Tyrion1606/robo_equilibrista_arduino_nano/docs/pinagem-dois-motores.png

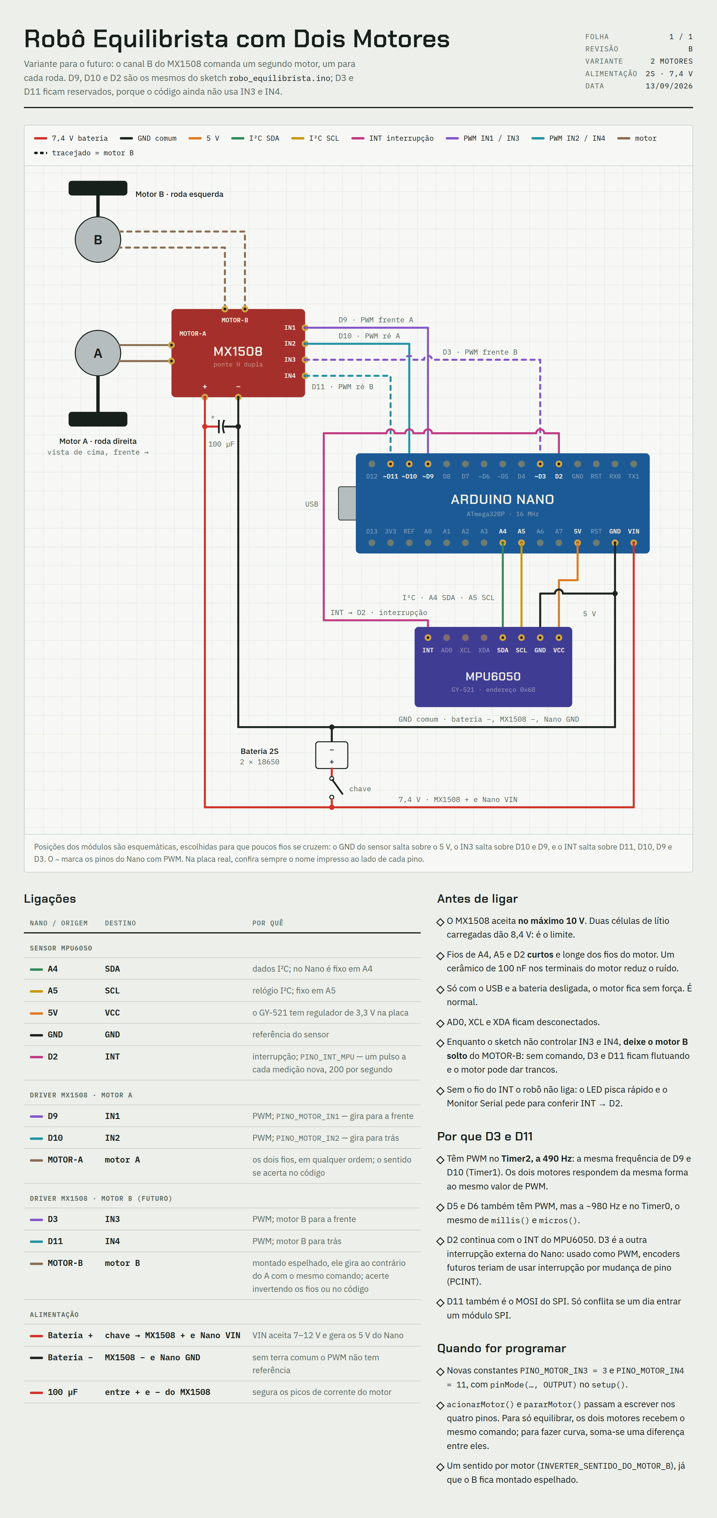
docs/pinagem-dois-motores.png
