Tyrion1606/robo_equilibrista_arduino_nano/docs/pinagem.png

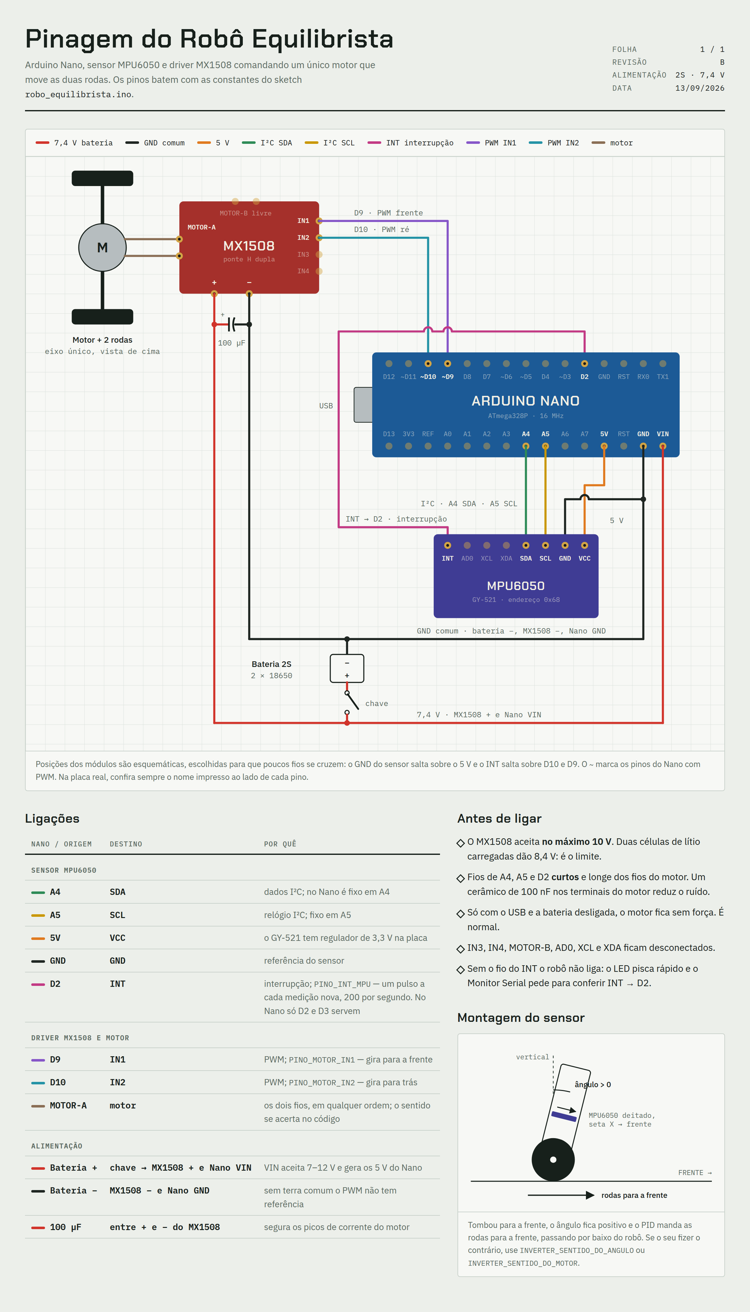
docs/pinagem.png
