Tyrion1606/robo_equilibrista_arduino_nano/estrutura_CAD/images/Base_v40.png

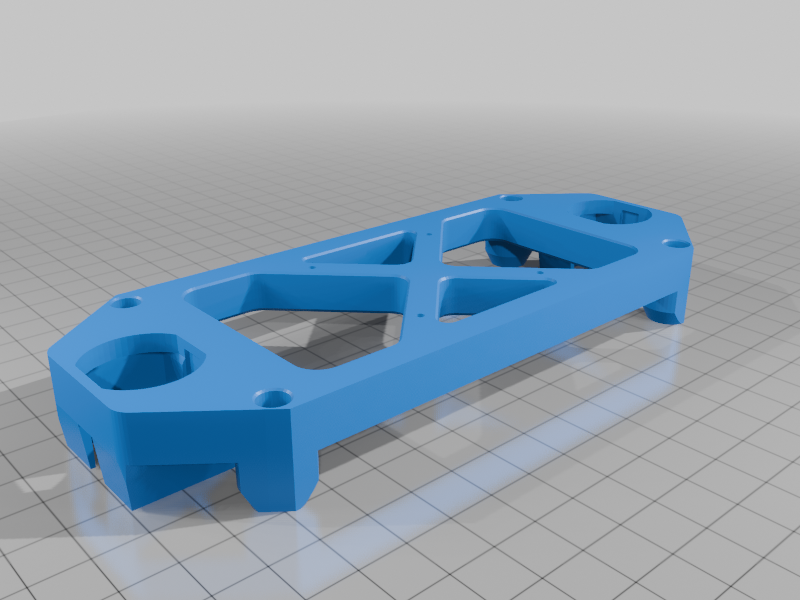
estrutura_CAD/images/Base_v40.png
