Tyrion1606/robo_equilibrista_arduino_nano/estrutura_CAD/images/BOT.png

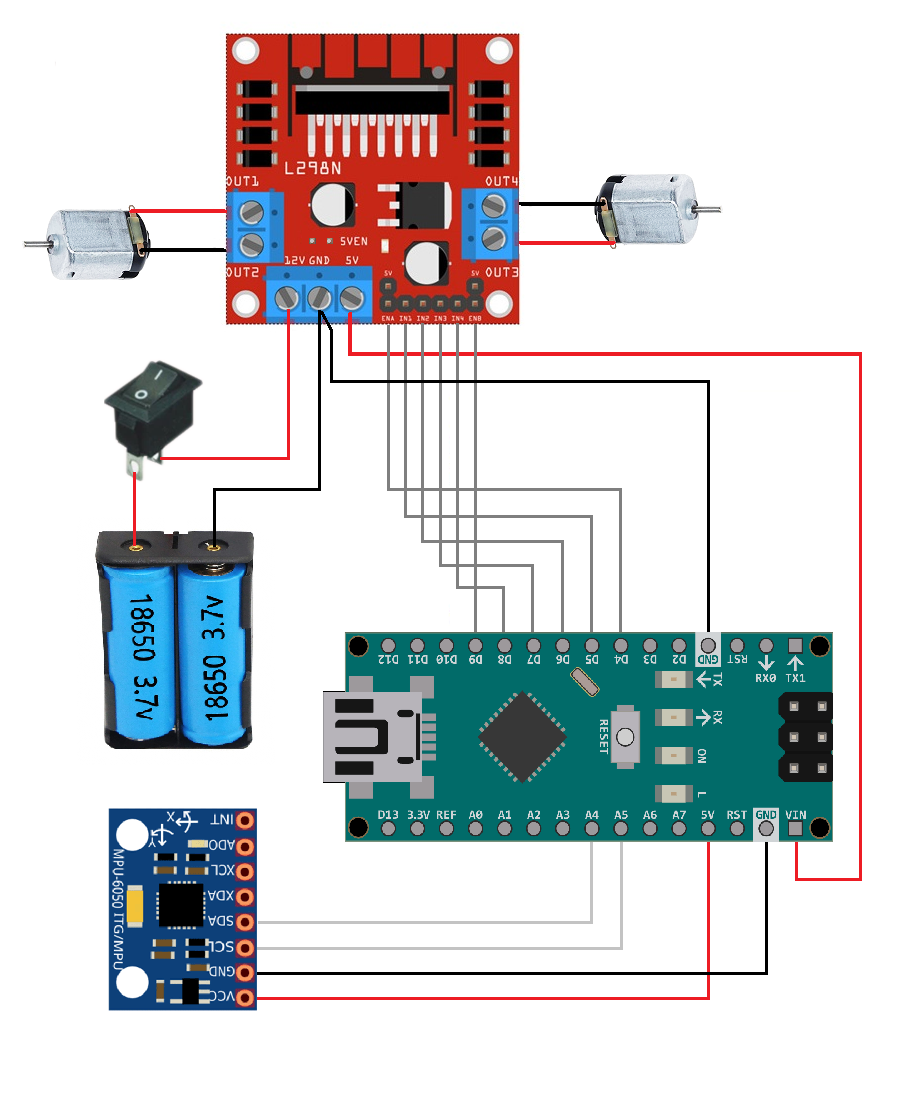
estrutura_CAD/images/BOT.png
