Tyrion1606/robo_equilibrista_arduino_nano/estrutura_CAD/images/ESP32C3.jpg

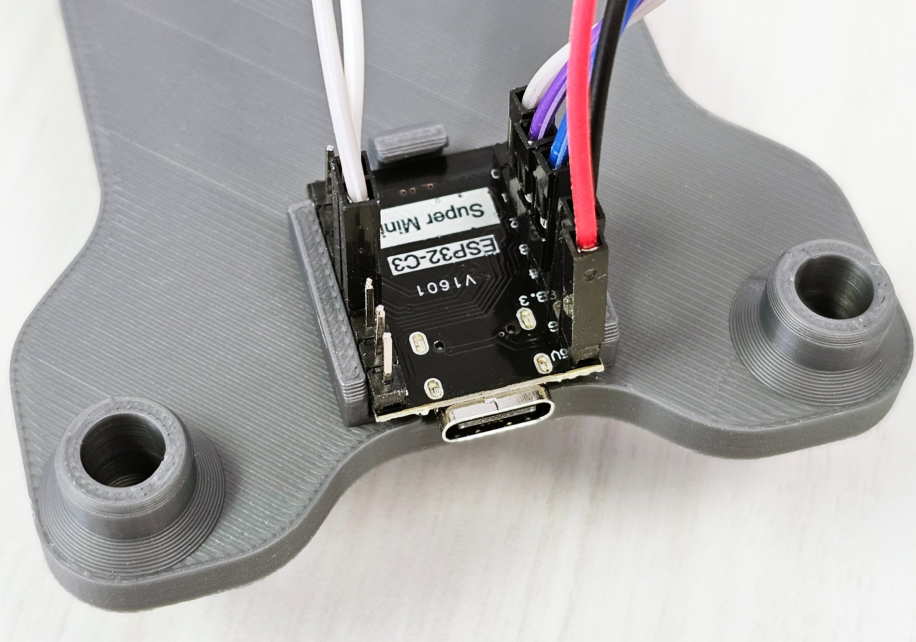
estrutura_CAD/images/ESP32C3.jpg
