Tyrion1606/robo_equilibrista_arduino_nano/estrutura_CAD/images/MidLevel.jpg

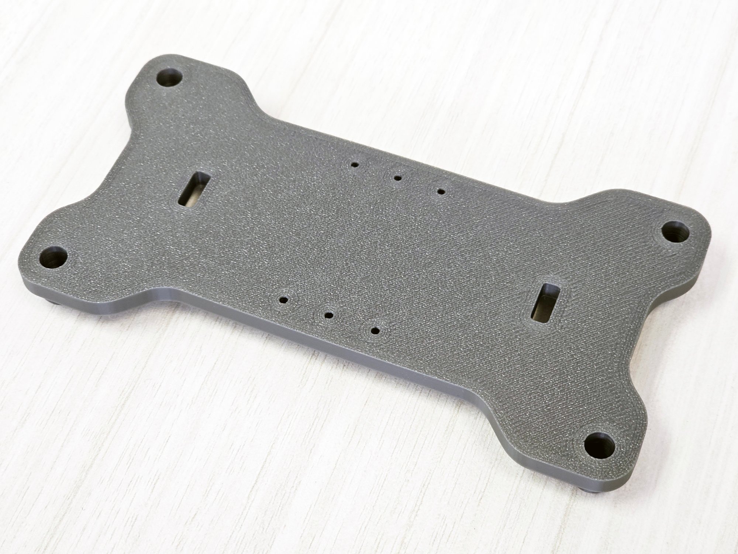
estrutura_CAD/images/MidLevel.jpg
