Tyrion1606/robo_equilibrista_arduino_nano/estrutura_CAD/images/MPU6050.jpg

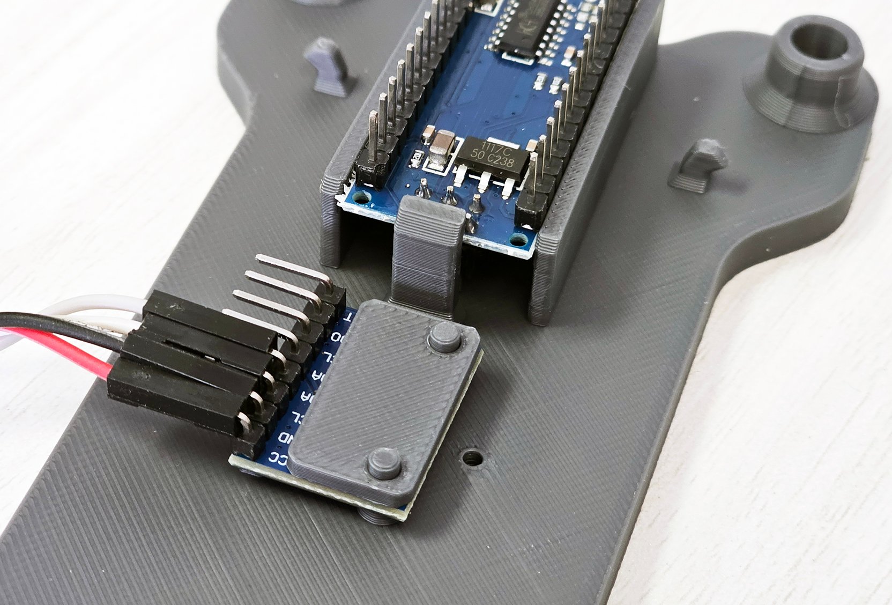
estrutura_CAD/images/MPU6050.jpg
