Tyrion1606/robo_equilibrista_arduino_nano/estrutura_CAD/images/Nano.jpg

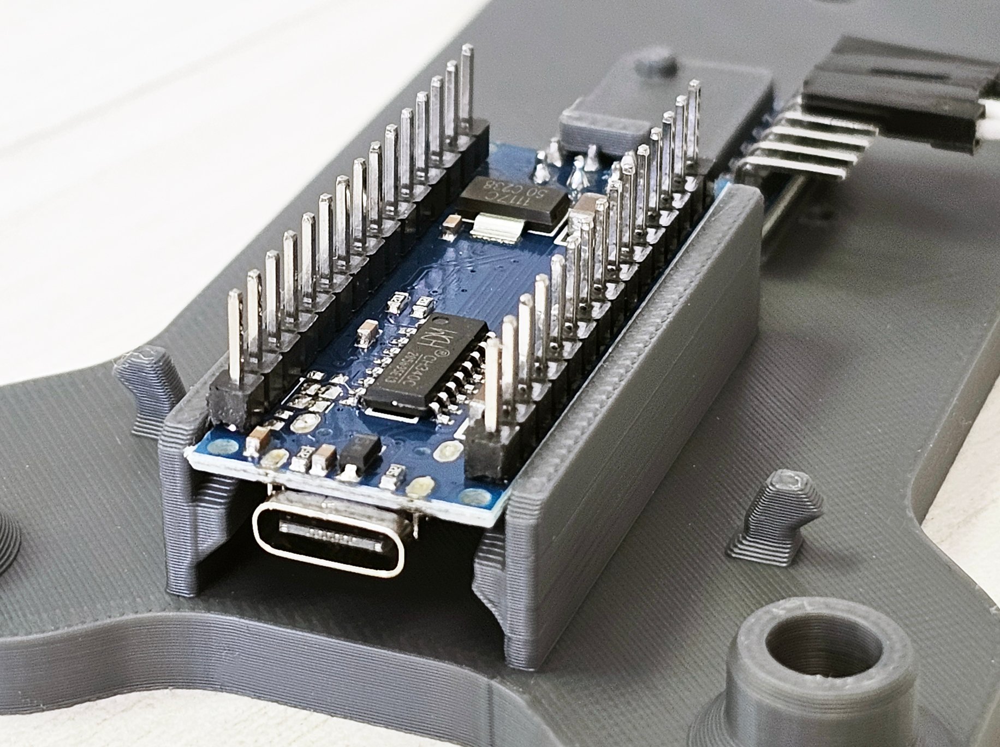
estrutura_CAD/images/Nano.jpg
