Tyrion1606/robo_equilibrista_arduino_nano/estrutura_CAD/files/Clip_v40.stl

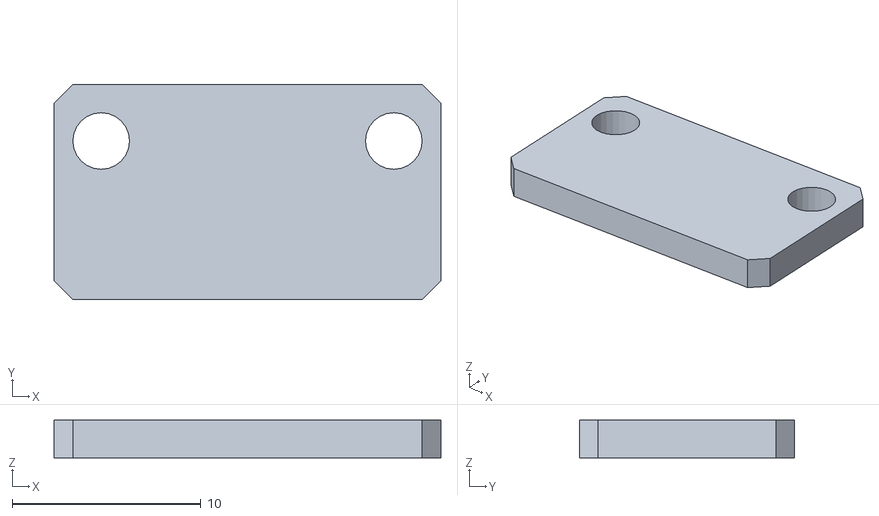
[picture p16: CAD file, 2026-09-20]
estrutura_CAD/files/Clip_v40.stl
20.5 x 11.4 x 2.00
