Tyrion1606/robo_equilibrista_arduino_nano/estrutura_CAD/files/Base_v40.stl

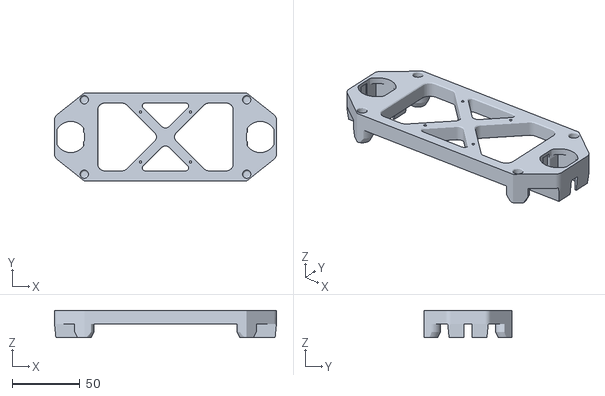
[picture p17: CAD file, 2026-09-20]
estrutura_CAD/files/Base_v40.stl
164.0 x 65.0 x 20.0
