Tyrion1606/robo_equilibrista_arduino_nano/estrutura_CAD/files/UpperESP32C3_v40.stl

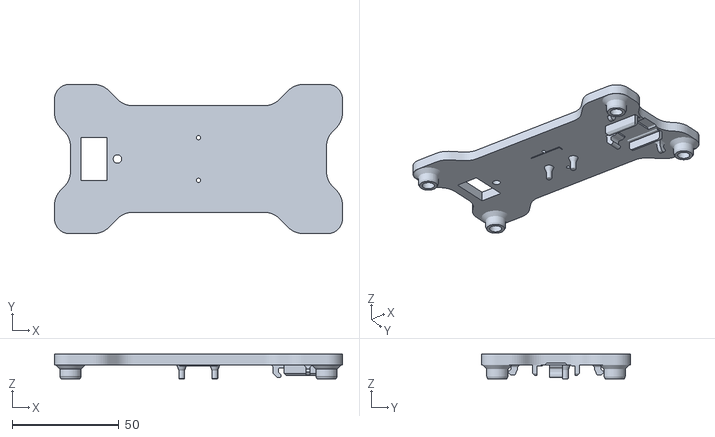
[picture p18: CAD file, 2026-09-20]
estrutura_CAD/files/UpperESP32C3_v40.stl
135.0 x 70.0 x 11.5
