Tyrion1606/robo_equilibrista_arduino_nano/robo_equilibrista/robo_equilibrista.ino

/*
 * =============================================================================
 *   ROBÔ EQUILIBRISTA
 *   Arduino Nano + MPU6050 (GY-521) + MX1508 — um único motor move as 2 rodas
 * =============================================================================
 *
 *   A IDEIA EM UMA FRASE
 *   --------------------
 *   O MPU6050 diz quanto o robô está inclinado; o PID decide com que força e
 *   para que lado girar o motor para colocar as rodas de volta embaixo do
 *   centro de massa — do mesmo jeito que você equilibra uma vassoura na mão.
 *
 *   O QUE ACONTECE A CADA MEDIÇÃO (200 POR SEGUNDO, SE NÃO MUDAR O DIVISOR)
 *   ------------------------------------------------------------------------
 *     0. O MPU6050 termina uma medição e avisa pelo pino INT (interrupção).
 *     1. Ler acelerômetro e giroscópio do MPU6050.
 *     2. Juntar as duas leituras num ângulo confiável (filtro complementar).
 *     3. Calcular a correção com o PID.
 *     4. Mandar a correção para o motor através do MX1508.
 *
 *   LIGAÇÕES
 *   --------
 *     MPU6050 VCC ........ Nano 5V
 *     MPU6050 GND ........ Nano GND
 *     MPU6050 SDA ........ Nano A4
 *     MPU6050 SCL ........ Nano A5
 *     MPU6050 INT ........ Nano D2   (interrupção)
 *     MX1508  IN1 ........ Nano D9   (PWM)
 *     MX1508  IN2 ........ Nano D10  (PWM)
 *     MX1508  MOTOR-A .... os dois fios do motor
 *     Bateria + (via chave) ... MX1508 "+"  e  Nano VIN
 *     Bateria − ............... MX1508 "−"  e  Nano GND   (terra comum!)
 *
 *   MONTAGEM DO SENSOR
 *   ------------------
 *     Módulo deitado (na horizontal), o mais perto possível do eixo das
 *     rodas, com a seta "X" impressa na placa apontando para a FRENTE.
 *
 *   CONVENÇÃO DE SINAIS USADA EM TODO O CÓDIGO
 *   ------------------------------------------
 *     ângulo positivo  = robô tombando para a frente
 *     comando positivo = rodas andando para a frente
 *   Se o seu robô fizer o contrário, não mexa nas contas: use as chaves
 *   INVERTER_SENTIDO_DO_ANGULO e INVERTER_SENTIDO_DO_MOTOR, mais abaixo.
 *
 *   AJUSTE PELO MONITOR SERIAL (115200 baud, final de linha "Nova linha")
 *   ---------------------------------------------------------------------
 *     kp 20                   muda o ganho proporcional
 *     ki 40                   muda o ganho integral
 *     kd 0.8                  muda o ganho derivativo
 *     angulo_equilibrio -1.5  muda o ângulo em que o robô fica em pé
 *     marcar_equilibrio       usa o ângulo atual como ângulo de equilíbrio
 *     pwm_minimo 40           muda o menor PWM que faz o motor girar
 *     angulo_queda 35         muda a inclinação a partir da qual o robô "caiu"
 *     peso_giroscopio 0.98    muda quanto o filtro confia no giroscópio (0 a 1)
 *     divisor_amostragem 4    muda quantas medições por segundo o MPU6050 faz (1 a 19)
 *     filtro_passa_baixas 3   muda o filtro interno do MPU6050 (1 a 6)
 *     escala_acelerometro 2   muda a faixa do acelerômetro: ±2, ±4, ±8 ou ±16 g
 *     usar_filtro_d 1         liga (1) ou desliga (0) o filtro só no termo D
 *     filtro_termo_d 25       frequência de corte desse filtro, em Hz
 *     usar_laco_velocidade 1  liga (1) ou desliga (0) o laço de velocidade
 *     kv 0.02                 ganho do laço de velocidade
 *     usar_curva 1            liga (1) ou desliga (0) a curva de resposta do motor
 *     curva_motor 0.5         quanto a curva suaviza perto do zero (0 a 1)
 *     usar_rampa 1            liga (1) ou desliga (0) a rampa do motor
 *     rampa_motor 1500        quanto o comando pode mudar por segundo
 *     telemetria              liga/desliga o envio de números para o computador
 *     valores                 mostra os valores atuais
 *     ajuda                   mostra esta lista
 *
 *   Cada comando que muda um valor responde "# ok nome=valor". A lista completa
 *   só sai ao ligar e com "valores": ela é longa, e imprimi-la a cada ajuste
 *   travaria o controle por dezenas de milissegundos.
 *
 *   Não precisa instalar biblioteca: o MPU6050 é lido direto pelo I2C (Wire).
 * =============================================================================
 */

#include <Wire.h>


// =============================================================================
//  1. PINOS
// =============================================================================

const int PINO_MOTOR_IN1 = 9;    // MX1508 IN1 — precisa ser um pino com PWM (~)
const int PINO_MOTOR_IN2 = 10;   // MX1508 IN2 — precisa ser um pino com PWM (~)
const int PINO_LED       = 13;   // LED da própria placa: aceso = equilibrando
const int PINO_INT_MPU   = 2;    // MPU6050 INT — no Nano, só D2 e D3 têm interrupção externa

// SDA e SCL do MPU6050 ficam em A4 e A5. No Nano esses pinos são fixos para o
// I2C, por isso não aparecem aqui.


// =============================================================================
//  2. GANHOS DO PID  (é aqui que se mexe quando for ajustar o robô)
// =============================================================================
//
//  A saída do PID é um comando de motor entre -255 (ré total) e +255 (frente
//  total). Cada ganho diz quanto de comando cada "sintoma" vale:
//
//  Kp — "quanto estou inclinado?"
//       Kp = 20 significa: 1 grau de inclinação vira 20 de comando.
//       Pouco Kp: o robô cai sem reagir direito.
//       Muito Kp: ele treme para a frente e para trás cada vez mais forte.
//
//  Ki — "há quanto tempo estou inclinado?"
//       Ki = 40 significa: 1 grau mantido por 1 segundo acumula 40 de comando.
//       Corrige o robô que vai "andando" para um lado até cair.
//       Muito Ki: oscilações lentas e largas. Comece em zero.
//
//  Kd — "com que velocidade estou caindo?"
//       Kd = 0.8 significa: caindo a 100 graus/s vira 80 de comando.
//       Funciona como um freio que amortece o tremor causado pelo Kp.
//       Muito Kd: vibração rápida e zumbido no motor.

float Kp = 20.0;
float Ki = 0.0;
float Kd = 0.8;

// Ângulo em que o robô fica em pé sozinho. Quase nunca é exatamente 0: depende
// de onde está o centro de massa e de quão reto o sensor foi fixado.
// O jeito mais fácil de achar: segure o robô equilibrado e mande
// "marcar_equilibrio" pelo Monitor Serial.
float anguloDeEquilibrio = 0.0;


// =============================================================================
//  3. OUTROS AJUSTES
// =============================================================================

// Descubra com o robô no ar (veja o README). Troque se estiver ao contrário.
const bool INVERTER_SENTIDO_DO_ANGULO = false;
const bool INVERTER_SENTIDO_DO_MOTOR  = false;

// Motores pequenos não giram com PWM baixo — só zumbem. Qualquer comando
// diferente de zero começa a partir deste valor ("zona morta").
int pwmMinimo = 40;
const int PWM_MAXIMO = 255;

// Limite do termo integral (em unidades de comando). Sem limite, enquanto o
// robô está inclinado a soma cresce sem parar e ele "dispara" depois.
const float LIMITE_DO_TERMO_INTEGRAL = 120.0;

// Segurança. O ângulo de queda pode ser mudado pela serial ("angulo_queda 35").
// Passou disso longe do equilíbrio: o robô caiu, desliga o motor. Muito baixo,
// ele "desiste" em inclinações que ainda daria para salvar; muito alto, o motor
// fica girando com o robô deitado no chão.
float anguloDeQueda = 35.0;
const float ANGULO_DE_QUEDA_MINIMO = 5.0;    // limites aceitos pelo comando
const float ANGULO_DE_QUEDA_MAXIMO = 80.0;
const float ANGULO_PARA_REARMAR = 3.0;       // volta a equilibrar quando for levantado até aqui

// Filtro complementar: quanto confiar no giroscópio, de 0 a 1. Pode ser mudado
// pela serial ("peso_giroscopio 0.98"). Veja a explicação em atualizarAngulo().
float pesoDoGiroscopio = 0.98;

// Ritmo do controle: quem manda é o próprio MPU6050, que mede e avisa cada
// medição nova pelo pino INT. Os dois ajustes abaixo vão direto para os
// registradores do sensor e podem ser mudados pela serial.
//
// DIVISOR DE AMOSTRAGEM  (registrador SMPLRT_DIV, comando "divisor_amostragem")
//   Com o filtro ligado, o sensor mede 1000 vezes por segundo por dentro. O
//   divisor escolhe quantas dessas medições viram aviso:
//
//       medições por segundo = 1000 / (1 + divisor)
//
//      1 → 500 por segundo, a cada  2 ms
//      4 → 200 por segundo, a cada  5 ms   ← padrão
//      9 → 100 por segundo, a cada 10 ms
//     19 →  50 por segundo, a cada 20 ms
//
//   Mais rápido: o robô reage antes, mas sobra menos tempo entre um aviso e
//   outro para ler o sensor (~1 ms de I2C) e mandar a telemetria.
//   Mais lento: sobra tempo, mas o PID só corrige a cada 10 ou 20 ms.
//   Mudar o divisor também muda a velocidade do filtro complementar (veja
//   atualizarAngulo()), porque o peso do giroscópio é aplicado a cada medição.
//
// FILTRO PASSA-BAIXAS  (registrador CONFIG, campo DLPF_CFG, comando "filtro_passa_baixas")
//   Tira do sinal o que vibra rápido (motor, engrenagens), mas atrasa a leitura.
//   Para o giroscópio, segundo o datasheet:
//
//      1 → corta acima de 188 Hz, atrasa  1,9 ms
//      2 → corta acima de  98 Hz, atrasa  2,8 ms
//      3 → corta acima de  42 Hz, atrasa  4,8 ms   ← padrão
//      4 → corta acima de  20 Hz, atrasa  8,3 ms
//      5 → corta acima de  10 Hz, atrasa 13,4 ms
//      6 → corta acima de   5 Hz, atrasa 18,6 ms
//
//   Motor zumbindo e termo D tremendo: suba. Robô atrasado, oscilando mesmo
//   com Kd alto: desça. O 0 (sem filtro) não é aceito: ele muda a medição
//   interna para 8000 por segundo e a conta do divisor deixaria de valer.
uint8_t divisorDeAmostragem = 4;
uint8_t filtroPassaBaixas   = 3;
const uint8_t DIVISOR_DE_AMOSTRAGEM_MINIMO = 1;    // limites aceitos pelos comandos
const uint8_t DIVISOR_DE_AMOSTRAGEM_MAXIMO = 19;
const uint8_t FILTRO_PASSA_BAIXAS_MINIMO   = 1;
const uint8_t FILTRO_PASSA_BAIXAS_MAXIMO   = 6;

// ESCALA DO ACELERÔMETRO  (registrador ACCEL_CONFIG, campo AFS_SEL, comando "escala_acelerometro")
//   Até quantos g o acelerômetro mede. A leitura é sempre um número de 16 bits
//   (−32768 a +32767); a escala diz a quanto o máximo corresponde:
//
//      ±2 g → 16384 unidades por g   ← padrão
//      ±4 g →  8192 unidades por g
//      ±8 g →  4096 unidades por g
//     ±16 g →  2048 unidades por g
//
//   O ângulo pelo acelerômetro usa só a proporção entre os eixos (atan2), então
//   nenhuma conta muda com a escala. Ela decide duas coisas: a resolução (±2 g
//   é a mais fina) e a partir de quanto o sensor satura (numa batida acima de
//   2 g, a escala ±2 g corta a leitura e o ângulo daquele instante sai errado).
//   Aqui a escala é guardada em g, que é mais fácil de ler que o código 0–3.
uint8_t escalaDoAcelerometroEmG = 2;

// Sem nenhum aviso por este tempo, o fio do INT soltou ou o sensor travou, e o
// motor é desligado. Vale o maior entre 10 avisos perdidos e 50 ms: com o
// sensor rápido, 10 avisos seriam só 20 ms, e imprimir os ajustes na serial
// já leva ~15 ms.
const unsigned long AVISOS_PERDIDOS_PARA_DESISTIR = 10;
const unsigned long TEMPO_MINIMO_SEM_AVISO_US     = 50000;

// De quanto em quanto tempo mandar os números para o computador.
const unsigned long INTERVALO_DA_TELEMETRIA_MS = 100;


// =============================================================================
//  4. TÉCNICAS PARA SUAVIZAR O MOTOR  (todas começam desligadas)
// =============================================================================
//
//  Cada técnica tem uma chave ("usar_…", 1 liga e 0 desliga) e um valor, e as
//  duas coisas podem ser mudadas pela serial a qualquer momento. Com todas
//  desligadas, o robô funciona exatamente como antes de elas existirem.
//  O caminho do comando é sempre:
//
//     PID (com o filtro no D e o laço de velocidade)  →  curva  →  rampa  →  motor
//
//  FILTRO NO TERMO D  ("usar_filtro_d", "filtro_termo_d")
//    O termo D multiplica a velocidade medida pelo giroscópio, que traz junto a
//    vibração do motor: é o termo que mais faz o comando pular. Este filtro
//    passa-baixas suaviza só a velocidade usada no D. O valor é a frequência de
//    corte em hertz: o que muda mais devagar que isso passa, o que vibra mais
//    rápido é atenuado. Assim dá para deixar o filtro_passa_baixas do MPU6050
//    mais fraco (menos atraso para o ângulo e o P) e filtrar só onde precisa.
//    Mais baixo = D mais liso, porém mais atrasado.
//
//  LAÇO DE VELOCIDADE  ("usar_laco_velocidade", "kv")
//    Um robô que só olha o ângulo tende a ir acelerando para um lado até o
//    motor saturar. Não há encoder, então a velocidade das rodas é estimada
//    pelo próprio comando mandado ao motor. Quando o robô vem andando, o laço
//    inclina o alvo para o lado contrário, porque para frear ele precisa se
//    inclinar para trás. kv = graus de inclinação do alvo por unidade de
//    comando: com 0.02 e o robô andando com comando médio de 100, o alvo
//    inclina 2° para trás.
//
//  CURVA DE RESPOSTA  ("usar_curva", "curva_motor")
//    Troca a linha reta entre o comando do PID e o motor por uma curva: suave
//    perto do zero, onde o robô passa a maior parte do tempo, e forte perto de
//    255, que continua disponível para salvar uma queda.
//
//        x = |comando| / 255        saída = 255 × ((1 − curva) × x + curva × x³)
//
//    curva 0 = reta (igual a não usar); curva 1 = cúbica, a mais suave no zero.
//
//  RAMPA  ("usar_rampa", "rampa_motor")
//    Limita quanto o comando pode mudar por segundo, em unidades de PWM. Com
//    1500, ir de 0 a 255 leva 0,17 s. Tira trancos e picos de corrente, mas
//    atrasa as correções grandes: rampa lenta demais e o robô cai.

bool  usarFiltroNoTermoD = false;
float frequenciaDoFiltroDoTermoD = 25.0;          // Hz
const float FREQUENCIA_DO_FILTRO_DO_TERMO_D_MINIMA = 1.0;
const float FREQUENCIA_DO_FILTRO_DO_TERMO_D_MAXIMA = 150.0;

bool  usarLacoDeVelocidade = false;
float Kv = 0.02;                                  // graus de alvo por unidade de comando
const float KV_MAXIMO = 0.5;
const float LIMITE_DA_INCLINACAO_DO_LACO = 10.0;  // o laço nunca inclina o alvo mais que isto
// O motor e o robô não mudam de velocidade na hora: a velocidade estimada segue
// o comando aos poucos, com esta constante de tempo (típica de um motor TT).
const float CONSTANTE_DE_TEMPO_DA_VELOCIDADE = 0.3;   // segundos

bool  usarCurva = false;
float curvaDoMotor = 0.5;                         // 0 = reta, 1 = cúbica

bool  usarRampa = false;
float rampaDoMotor = 1500.0;                      // unidades de PWM por segundo
const float RAMPA_DO_MOTOR_MINIMA = 50.0;
const float RAMPA_DO_MOTOR_MAXIMA = 20000.0;


// =============================================================================
//  5. MPU6050 — endereço e registradores (valores tirados do datasheet)
// =============================================================================

const uint8_t ENDERECO_MPU6050 = 0x68;   // com o pino AD0 solto ou em GND

const uint8_t REG_DIVISOR_DE_AMOSTRAGEM = 0x19;  // SMPLRT_DIV
const uint8_t REG_FILTRO_PASSA_BAIXAS   = 0x1A;  // CONFIG
const uint8_t REG_ESCALA_GIROSCOPIO     = 0x1B;  // GYRO_CONFIG
const uint8_t REG_ESCALA_ACELEROMETRO   = 0x1C;  // ACCEL_CONFIG
const uint8_t REG_CONFIGURACAO_DO_INT   = 0x37;  // INT_PIN_CFG
const uint8_t REG_INTERRUPCOES_LIGADAS  = 0x38;  // INT_ENABLE
const uint8_t REG_PRIMEIRO_DADO         = 0x3B;  // ACCEL_XOUT_H: início das leituras
const uint8_t REG_ENERGIA               = 0x6B;  // PWR_MGMT_1

// Na escala de ±500 graus/s, cada 65,5 unidades lidas equivalem a 1 grau/s.
const float UNIDADES_POR_GRAU_POR_SEGUNDO = 65.5;


// =============================================================================
//  6. ESTADO DO ROBÔ (valores que mudam enquanto ele funciona)
// =============================================================================

// Uma leitura completa do sensor, em unidades "cruas" (ainda sem conversão).
struct LeituraDoSensor {
  int16_t acelX, acelY, acelZ;
  int16_t giroX, giroY, giroZ;
};

float anguloAtual        = 0.0;  // graus;    positivo = tombado para a frente
float velocidadeAngular  = 0.0;  // graus/s;  positivo = tombando para a frente
float desvioDoGiroscopio = 0.0;  // graus/s que o giroscópio marca mesmo parado

float termoIntegral = 0.0;       // a "memória" do PID, já em unidades de comando
float ultimoTermoP  = 0.0;       // P e D guardados só para aparecer na telemetria
float ultimoTermoD  = 0.0;
float ultimoComando = 0.0;       // o que foi pedido ao motor por último (depois da curva e da rampa)
float ultimoComandoDoPid = 0.0;  // o que o PID pediu, antes da curva e da rampa
float ultimoTermoV  = 0.0;       // graus que o laço de velocidade somou ao alvo

float velocidadeFiltradaParaD = 0.0;  // graus/s: a velocidade do giroscópio depois do filtro do termo D
float velocidadeEstimada      = 0.0;  // unidades de comando: para que lado e quão forte o robô vem andando

bool equilibrando = false;       // false = caído, esperando ser levantado

unsigned long instanteDoUltimoCiclo      = 0;  // em micros(): quando chegou a amostra usada por último
unsigned long instanteDaUltimaTelemetria = 0;  // em millis()
bool telemetriaLigada = true;

// Preenchidas dentro da interrupção, por isso "volatile": avisa o compilador
// que elas podem mudar a qualquer momento, fora do fluxo normal do loop().
volatile bool          chegouAmostraNova   = false;
volatile unsigned long instanteDaAmostraNova = 0;   // em micros()
bool sensorAvisando = true;      // false depois que os avisos pararam de chegar

char bufferDaSerial[32];         // guarda o comando enquanto ele chega letra a letra
int  tamanhoDoBuffer = 0;


// =============================================================================
//  SETUP — roda uma vez, ao ligar
// =============================================================================

void setup() {
  Serial.begin(115200);

  pinMode(PINO_MOTOR_IN1, OUTPUT);
  pinMode(PINO_MOTOR_IN2, OUTPUT);
  pinMode(PINO_LED, OUTPUT);
  pararMotor();

  Serial.println(F("\n# Robo equilibrista iniciando..."));

  Wire.begin();
  Wire.setClock(400000);             // I2C no modo rápido (400 kHz)
  Wire.setWireTimeout(3000, true);   // se um fio soltar, o I2C desiste em vez de travar

  if (!iniciarMPU6050()) {
    travarComErro(F("# ERRO: o MPU6050 nao respondeu. Confira VCC, GND, SDA (A4) e SCL (A5)."));
  }

  // A partir daqui, cada medição nova do sensor chama receberAvisoDoMPU6050().
  // RISING = na subida do pulso do INT (de 0 V para 5 V).
  pinMode(PINO_INT_MPU, INPUT);
  attachInterrupt(digitalPinToInterrupt(PINO_INT_MPU), receberAvisoDoMPU6050, RISING);

  if (!esperarAmostraNova()) {
    travarComErro(F("# ERRO: o MPU6050 responde, mas nao avisa pelo INT. Confira o fio INT -> D2."));
  }

  calibrarGiroscopio();

  // O filtro precisa de um ponto de partida: usamos o ângulo que o
  // acelerômetro enxerga agora.
  LeituraDoSensor leitura;
  if (lerMPU6050(leitura)) {
    anguloAtual = calcularAnguloPeloAcelerometro(leitura);
  }

  mostrarAjustes();
  Serial.println(F("# Coloque o robo em pe para comecar. Digite \"ajuda\" para ver os comandos."));

  // Joga fora um aviso que tenha chegado durante as mensagens acima: o primeiro
  // ciclo do loop() usa uma amostra fresca.
  unsigned long descartado;
  instanteDoUltimoCiclo = micros();
  pegarAmostraNova(descartado);
}


// =============================================================================
//  LOOP — roda sem parar
// =============================================================================

void loop() {
  // Comandos do computador e telemetria podem ser atendidos a qualquer hora...
  lerComandosDaSerial();
  enviarTelemetria();

  // ...mas o controle só roda quando o MPU6050 avisa que mediu de novo. Assim
  // cada ciclo usa uma medição nova, nem repetida nem atrasada, no ritmo fixo
  // do relógio do próprio sensor.
  unsigned long instanteDaAmostra;
  if (!pegarAmostraNova(instanteDaAmostra)) {
    verificarSeOSensorSumiu();
    return;   // nada novo ainda
  }

  // O tempo entre as amostras vem do instante em que cada aviso chegou, e não
  // de quando o loop() conseguiu atender: é o intervalo real entre as medições.
  unsigned long microssegundosDesdeOUltimoCiclo = instanteDaAmostra - instanteDoUltimoCiclo;
  instanteDoUltimoCiclo = instanteDaAmostra;

  // Voltando de um sumiço, o intervalo seria enorme e o ângulo guardado está
  // velho: recomeçamos o ângulo pelo acelerômetro, como no setup().
  bool voltouDeUmSumico = !sensorAvisando ||
                          microssegundosDesdeOUltimoCiclo > tempoMaximoSemAvisoUs();
  if (voltouDeUmSumico) {
    microssegundosDesdeOUltimoCiclo = intervaloEntreAmostrasUs();
  }
  sensorAvisando = true;
  float segundosDesdeOUltimoCiclo = microssegundosDesdeOUltimoCiclo / 1000000.0;

  // --- Passos 1 e 2: onde estou? ---------------------------------------------
  LeituraDoSensor leitura;
  if (!lerMPU6050(leitura)) {
    // Sem sensor não dá para equilibrar: melhor desligar do que chutar.
    if (equilibrando) {
      Serial.println(F("# Falha na leitura do MPU6050. Motor desligado."));
    }
    equilibrando = false;
    pararMotor();
    digitalWrite(PINO_LED, LOW);
    return;
  }
  if (voltouDeUmSumico) {
    anguloAtual = calcularAnguloPeloAcelerometro(leitura);
  }
  atualizarAngulo(leitura, segundosDesdeOUltimoCiclo);

  // --- Passos 3 e 4: o que fazer? --------------------------------------------
  float distanciaDoEquilibrio = fabs(anguloAtual - anguloDeEquilibrio);

  if (equilibrando) {
    if (distanciaDoEquilibrio > anguloDeQueda) {
      // Inclinado demais: não tem mais como salvar. Desliga tudo.
      equilibrando = false;
      pararMotor();
      Serial.println(F("# Caiu. Levante o robo para recomecar."));
    } else {
      float comandoDoPid = calcularPID(segundosDesdeOUltimoCiclo);
      acionarMotor(suavizarComando(comandoDoPid, segundosDesdeOUltimoCiclo));
      atualizarVelocidadeEstimada(segundosDesdeOUltimoCiclo);
    }
  } else if (distanciaDoEquilibrio < ANGULO_PARA_REARMAR) {
    // Alguém levantou o robô até perto do equilíbrio: começa do zero.
    zerarPID();
    equilibrando = true;
    Serial.println(F("# Em pe! Equilibrando."));
  }

  digitalWrite(PINO_LED, equilibrando ? HIGH : LOW);
}

// Sem avisos há tempo demais, o controle não roda — e o motor ficaria preso no
// último comando. Melhor desligar.
void verificarSeOSensorSumiu() {
  if (!sensorAvisando || micros() - instanteDoUltimoCiclo <= tempoMaximoSemAvisoUs()) {
    return;
  }
  sensorAvisando = false;
  equilibrando = false;
  pararMotor();
  digitalWrite(PINO_LED, LOW);
  Serial.println(F("# Falha: o MPU6050 parou de avisar pelo INT (D2). Motor desligado."));
}

// Intervalo esperado entre dois avisos do MPU6050: cada medição interna leva
// 1 ms (1000 µs), e o divisor pula "divisor" delas.
unsigned long intervaloEntreAmostrasUs() {
  return 1000UL * (1 + divisorDeAmostragem);
}

unsigned long tempoMaximoSemAvisoUs() {
  return max(AVISOS_PERDIDOS_PARA_DESISTIR * intervaloEntreAmostrasUs(), TEMPO_MINIMO_SEM_AVISO_US);
}

// Pisca rápido para sempre: algo está errado e não dá para continuar.
void travarComErro(const __FlashStringHelper *mensagem) {
  Serial.println(mensagem);
  while (true) {
    digitalWrite(PINO_LED, !digitalRead(PINO_LED));
    delay(100);
  }
}


// =============================================================================
//  ÂNGULO — FILTRO COMPLEMENTAR
// =============================================================================
//
//  Nenhum dos dois sensores, sozinho, entrega um ângulo bom:
//
//   • ACELERÔMETRO: sente a gravidade, então sempre sabe onde é "para baixo" e
//     nunca se perde com o tempo. Mas qualquer tranco ou vibração do motor
//     também aparece como se fosse inclinação.
//     → bom a longo prazo, ruim no instante.
//
//   • GIROSCÓPIO: mede a velocidade de giro, liso e imune a trancos. Somando
//     essa velocidade a cada ciclo temos o ângulo — só que qualquer errinho
//     também vai sendo somado, e o ângulo "escorrega" aos poucos.
//     → bom no instante, ruim a longo prazo.
//
//  Misturando 98% do giroscópio com 2% do acelerômetro, ficamos com o melhor
//  dos dois: o giroscópio acompanha os movimentos rápidos e o acelerômetro,
//  devagarinho, puxa o ângulo de volta para o valor verdadeiro.
//
//  Quão devagar? A cada ciclo, só (1 − peso) da diferença entre os dois é
//  corrigida. Isso dá uma "constante de tempo" de
//
//      intervalo × peso / (1 − peso)  =  5 ms × 0,98 / 0,02  ≈  0,25 s
//
//  (5 ms é o intervalo com o divisor de amostragem padrão; com outro divisor,
//  o mesmo peso corrige mais depressa ou mais devagar.)
//
//  Movimentos mais rápidos que isso vêm do giroscópio; tendências mais lentas,
//  do acelerômetro.
//     peso 0,95  → ~0,1 s: corrige o escorregamento rápido, mas deixa passar
//                  mais trancos do motor para o ângulo.
//     peso 0,995 → ~1 s:   ângulo bem liso, mas um giroscópio que escorrega
//                  demora a ser corrigido.
//     peso 1     → nunca corrige: o ângulo escorrega até o robô cair.

void atualizarAngulo(const LeituraDoSensor &leitura, float segundosDesdeOUltimoCiclo) {
  float anguloPeloAcelerometro = calcularAnguloPeloAcelerometro(leitura);

  // Com o sensor deitado e o X para a frente, tombar para a frente é girar em
  // torno do eixo Y do sensor.
  velocidadeAngular = leitura.giroY / UNIDADES_POR_GRAU_POR_SEGUNDO - desvioDoGiroscopio;
  if (INVERTER_SENTIDO_DO_ANGULO) {
    velocidadeAngular = -velocidadeAngular;
  }

  float anguloPeloGiroscopio = anguloAtual + velocidadeAngular * segundosDesdeOUltimoCiclo;

  anguloAtual = pesoDoGiroscopio         * anguloPeloGiroscopio
              + (1.0 - pesoDoGiroscopio) * anguloPeloAcelerometro;
}

float calcularAnguloPeloAcelerometro(const LeituraDoSensor &leitura) {
  // Parado e reto, o acelerômetro sente toda a gravidade no eixo Z. Quando o
  // robô tomba para a frente, parte dela "passa" para o eixo X. O arco-tangente
  // da relação entre as duas partes é o ângulo de inclinação.
  float angulo = atan2(-(float)leitura.acelX, (float)leitura.acelZ) * RAD_TO_DEG;

  if (INVERTER_SENTIDO_DO_ANGULO) {
    angulo = -angulo;
  }
  return angulo;
}

// Todo giroscópio marca uma pequena velocidade mesmo parado. Medimos esse
// desvio ao ligar, com o robô imóvel, e descontamos dele em todas as leituras.
void calibrarGiroscopio() {
  // Sempre 2 segundos de medições, seja qual for o divisor de amostragem.
  const int QUANTIDADE_DE_AMOSTRAS = 2000000UL / intervaloEntreAmostrasUs();

  Serial.println(F("# Calibrando o giroscopio: deixe o robo PARADO por 2 segundos..."));

  float soma = 0.0;
  int leiturasValidas = 0;

  for (int i = 0; i < QUANTIDADE_DE_AMOSTRAS; i++) {
    LeituraDoSensor leitura;
    // Espera cada medição nova, para não somar a mesma leitura duas vezes.
    if (esperarAmostraNova() && lerMPU6050(leitura)) {
      soma += leitura.giroY / UNIDADES_POR_GRAU_POR_SEGUNDO;
      leiturasValidas++;
    }
    if (i % 20 == 0) {
      digitalWrite(PINO_LED, !digitalRead(PINO_LED));   // pisca enquanto calibra
    }
  }

  if (leiturasValidas > 0) {
    desvioDoGiroscopio = soma / leiturasValidas;
  }
  digitalWrite(PINO_LED, LOW);

  Serial.print(F("# Desvio do giroscopio: "));
  Serial.print(desvioDoGiroscopio, 3);
  Serial.println(F(" graus/s"));
}


// =============================================================================
//  PID
// =============================================================================
//
//  Entra: o ângulo atual (já filtrado) e a velocidade com que ele muda.
//  Sai:   um comando para o motor, de -255 (ré total) a +255 (frente total).

float calcularPID(float segundosDesdeOUltimoCiclo) {
  // ALVO: normalmente é o ângulo de equilíbrio. Com o laço de velocidade
  // ligado, andando para a frente o alvo inclina para trás (e vice-versa), que
  // é o que faz o robô frear. Veja a seção 4.
  float correcaoDoAlvo = 0.0;
  if (usarLacoDeVelocidade) {
    correcaoDoAlvo = constrain(-Kv * velocidadeEstimada, -LIMITE_DA_INCLINACAO_DO_LACO, LIMITE_DA_INCLINACAO_DO_LACO);
  }
  ultimoTermoV = correcaoDoAlvo;
  float alvo = anguloDeEquilibrio + correcaoDoAlvo;

  // ERRO: quantos graus estamos longe do alvo.
  // Positivo = tombando para a frente = as rodas precisam ir para a frente
  // para "passar por baixo" do robô. Por isso o erro é (atual − alvo), e não
  // (alvo − atual) como costuma aparecer nos livros: assim a correção já sai
  // com o sinal certo e todos os ganhos ficam positivos.
  float erro = anguloAtual - alvo;

  // P — PROPORCIONAL: quanto maior a inclinação, mais força.
  float termoP = Kp * erro;

  // I — INTEGRAL: vai somando o erro ao longo do tempo. Guardamos a soma já
  // multiplicada pelo Ki, assim mudar o Ki pela serial não dá um solavanco.
  // O limite impede que a soma cresça sem fim (o chamado "anti-windup").
  termoIntegral += Ki * erro * segundosDesdeOUltimoCiclo;
  termoIntegral = constrain(termoIntegral, -LIMITE_DO_TERMO_INTEGRAL, LIMITE_DO_TERMO_INTEGRAL);

  // D — DERIVATIVO: reage à velocidade com que o erro muda. Como o alvo é
  // fixo, essa velocidade é exatamente o que o giroscópio mede. Usar o
  // giroscópio direto dá um sinal muito mais limpo do que fazer
  // (erro atual − erro anterior) / tempo, que amplifica o ruído.
  float termoD = Kd * velocidadeParaOTermoD(segundosDesdeOUltimoCiclo);

  ultimoTermoP = termoP;
  ultimoTermoD = termoD;

  float comando = constrain(termoP + termoIntegral + termoD, -PWM_MAXIMO, PWM_MAXIMO);
  ultimoComandoDoPid = comando;
  return comando;
}

// FILTRO NO TERMO D: passa-baixas de primeira ordem. A cada medição, a saída
// anda uma fração "alfa" do caminho até o valor novo. Alfa sai da frequência
// de corte: quanto mais baixa, menor o passo e mais liso (e atrasado) o sinal.
float velocidadeParaOTermoD(float segundosDesdeOUltimoCiclo) {
  if (!usarFiltroNoTermoD) {
    velocidadeFiltradaParaD = velocidadeAngular;   // fica pronta para quando o filtro for ligado
    return velocidadeAngular;
  }
  float constanteDeTempo = 1.0 / (2.0 * PI * frequenciaDoFiltroDoTermoD);
  float alfa = segundosDesdeOUltimoCiclo / (segundosDesdeOUltimoCiclo + constanteDeTempo);
  velocidadeFiltradaParaD += alfa * (velocidadeAngular - velocidadeFiltradaParaD);
  return velocidadeFiltradaParaD;
}

// LAÇO DE VELOCIDADE: como o motor não muda de velocidade na hora, a velocidade
// estimada segue o comando aos poucos (o mesmo passa-baixas, com constante de
// tempo de 0,3 s). Não é a velocidade real, mas diz para que lado e quão forte
// o robô vem andando. É atualizada sempre, para estar pronta quando o laço ligar.
void atualizarVelocidadeEstimada(float segundosDesdeOUltimoCiclo) {
  float alfa = segundosDesdeOUltimoCiclo / (segundosDesdeOUltimoCiclo + CONSTANTE_DE_TEMPO_DA_VELOCIDADE);
  velocidadeEstimada += alfa * (ultimoComando - velocidadeEstimada);
}

// CURVA e RAMPA: mexem no comando que já saiu do PID, antes de ele ir para o
// motor. Veja a seção 4.
float suavizarComando(float comando, float segundosDesdeOUltimoCiclo) {
  if (usarCurva) {
    float x = fabs(comando) / PWM_MAXIMO;                                  // 0 a 1, sem o sinal
    float y = (1.0 - curvaDoMotor) * x + curvaDoMotor * x * x * x;
    comando = (comando < 0 ? -y : y) * PWM_MAXIMO;
  }

  if (usarRampa) {
    // Compara com o que foi mandado ao motor no ciclo anterior.
    float variacaoMaxima = rampaDoMotor * segundosDesdeOUltimoCiclo;
    comando = constrain(comando, ultimoComando - variacaoMaxima, ultimoComando + variacaoMaxima);
  }

  return comando;
}

// Começa do zero quando o robô é levantado: nada do que foi acumulado caído vale.
void zerarPID() {
  termoIntegral = 0.0;
  velocidadeEstimada = 0.0;
  velocidadeFiltradaParaD = velocidadeAngular;
}


// =============================================================================
//  MOTOR — MX1508
// =============================================================================
//
//  O MX1508 não tem pino "enable": cada motor usa dois pinos de entrada, e é a
//  combinação deles que decide o sentido.
//
//      IN1    IN2    motor
//      PWM    0      gira para a frente, com força proporcional ao PWM
//      0      PWM    gira para trás
//      0      0      solto (roda livre)

void acionarMotor(float comando) {
  ultimoComando = comando;

  if (INVERTER_SENTIDO_DO_MOTOR) {
    comando = -comando;
  }

  int forca = (int)fabs(comando);   // de 0 a 255, sem o sinal
  if (forca == 0) {
    pararMotor();
    return;
  }

  // Zona morta: espalha 1..255 dentro de pwmMinimo..255, para que até o
  // menor comando já faça a roda se mexer.
  int pwm = map(forca, 1, PWM_MAXIMO, pwmMinimo, PWM_MAXIMO);

  if (comando > 0) {
    analogWrite(PINO_MOTOR_IN1, pwm);   // para a frente
    analogWrite(PINO_MOTOR_IN2, 0);
  } else {
    analogWrite(PINO_MOTOR_IN1, 0);     // para trás
    analogWrite(PINO_MOTOR_IN2, pwm);
  }
}

void pararMotor() {
  analogWrite(PINO_MOTOR_IN1, 0);
  analogWrite(PINO_MOTOR_IN2, 0);
  ultimoComando = 0.0;
}


// =============================================================================
//  MPU6050 — conversa pelo I2C
// =============================================================================

// Grava um valor num registrador. Devolve true se o sensor confirmou.
bool escreverRegistrador(uint8_t registrador, uint8_t valor) {
  Wire.beginTransmission(ENDERECO_MPU6050);
  Wire.write(registrador);
  Wire.write(valor);
  return Wire.endTransmission() == 0;   // 0 = recebido com sucesso
}

bool iniciarMPU6050() {
  // O MPU6050 liga "dormindo". Acordamos e mandamos usar o relógio do
  // giroscópio, que é mais estável que o oscilador interno.
  if (!escreverRegistrador(REG_ENERGIA, 0x01)) {
    return false;
  }
  delay(100);

  bool tudoCerto = true;

  // Filtro passa-baixas e divisor de amostragem: veja a explicação junto de
  // divisorDeAmostragem e filtroPassaBaixas, lá em cima. No registrador CONFIG
  // os bits acima do filtro (sincronia externa) ficam em zero, por isso o valor
  // do filtro vai direto.
  tudoCerto &= escreverRegistrador(REG_FILTRO_PASSA_BAIXAS, filtroPassaBaixas);
  tudoCerto &= escreverRegistrador(REG_DIVISOR_DE_AMOSTRAGEM, divisorDeAmostragem);

  // Giroscópio em ±500 graus/s. Acelerômetro na escala escolhida lá em cima.
  tudoCerto &= escreverRegistrador(REG_ESCALA_GIROSCOPIO, 0x08);
  tudoCerto &= escreverRegistrador(REG_ESCALA_ACELEROMETRO, valorDoRegistradorDeEscala(escalaDoAcelerometroEmG));

  // Pino INT: sobe para nível alto num pulso curto (50 µs) a cada medição nova.
  // Nesse modo o pulso vem mesmo que a leitura anterior tenha se perdido; no
  // modo "travado" o pino ficaria alto esperando uma leitura, e o robô, parado.
  tudoCerto &= escreverRegistrador(REG_CONFIGURACAO_DO_INT, 0x00);
  // Liga só o aviso de "dado pronto" (DATA_RDY_EN).
  tudoCerto &= escreverRegistrador(REG_INTERRUPCOES_LIGADAS, 0x01);

  return tudoCerto;
}

// Chamada pela interrupção a cada pulso do INT. Tem que ser rápida: só anota
// que chegou e quando. A leitura pelo I2C fica para o loop(), porque o Wire
// depende de outras interrupções que ficam paradas enquanto esta roda.
void receberAvisoDoMPU6050() {
  instanteDaAmostraNova = micros();
  chegouAmostraNova = true;
}

// Devolve true se chegou amostra nova desde a última consulta, e o instante
// em que ela chegou. As interrupções ficam paradas por um instante durante a
// cópia: sem isso, um aviso no meio poderia deixar os dois valores trocados.
bool pegarAmostraNova(unsigned long &instante) {
  noInterrupts();
  bool chegou = chegouAmostraNova;
  instante = instanteDaAmostraNova;
  chegouAmostraNova = false;
  interrupts();
  return chegou;
}

// Espera o próximo aviso do MPU6050. Devolve false se ele não vier em 100 ms.
bool esperarAmostraNova() {
  unsigned long inicio = millis();
  unsigned long instante;
  while (!pegarAmostraNova(instante)) {
    if (millis() - inicio > 100) {
      return false;
    }
  }
  return true;
}

// Arredonda um pedido qualquer ("escala_acelerometro 5") para a escala mais
// próxima que o MPU6050 tem: 2, 4, 8 ou 16 g.
uint8_t escalaDoAcelerometroMaisProxima(float pedidoEmG) {
  if (pedidoEmG < 3)  return 2;
  if (pedidoEmG < 6)  return 4;
  if (pedidoEmG < 12) return 8;
  return 16;
}

// No registrador ACCEL_CONFIG a escala fica nos bits 4 e 3 (AFS_SEL): 0 = ±2 g,
// 1 = ±4 g, 2 = ±8 g, 3 = ±16 g. Os bits 7 a 5 (autoteste) ficam em zero.
uint8_t valorDoRegistradorDeEscala(uint8_t escalaEmG) {
  uint8_t afsSel = 0;
  switch (escalaEmG) {
    case 4:  afsSel = 1; break;
    case 8:  afsSel = 2; break;
    case 16: afsSel = 3; break;
    default: afsSel = 0; break;   // 2 g
  }
  return afsSel << 3;
}

// Lê acelerômetro e giroscópio de uma vez. Devolve false se algo falhar.
bool lerMPU6050(LeituraDoSensor &leitura) {
  // Os dados ficam em 14 bytes seguidos a partir do registrador 0x3B, nesta
  // ordem (2 bytes cada): acelX, acelY, acelZ, temperatura, giroX, giroY, giroZ.
  Wire.beginTransmission(ENDERECO_MPU6050);
  Wire.write(REG_PRIMEIRO_DADO);
  if (Wire.endTransmission(false) != 0) {
    return false;
  }
  if (Wire.requestFrom(ENDERECO_MPU6050, (uint8_t)14) != 14) {
    return false;
  }

  leitura.acelX = lerDoisBytes();
  leitura.acelY = lerDoisBytes();
  leitura.acelZ = lerDoisBytes();
  lerDoisBytes();                      // temperatura: não usamos
  leitura.giroX = lerDoisBytes();
  leitura.giroY = lerDoisBytes();
  leitura.giroZ = lerDoisBytes();
  return true;
}

// Cada valor chega em 2 bytes, o mais significativo primeiro.
int16_t lerDoisBytes() {
  uint8_t byteAlto  = Wire.read();
  uint8_t byteBaixo = Wire.read();
  return (int16_t)((byteAlto << 8) | byteBaixo);
}


// =============================================================================
//  SERIAL — ajuste ao vivo e telemetria
// =============================================================================

// Junta as letras que chegam até formar uma linha, e então executa o comando.
void lerComandosDaSerial() {
  while (Serial.available() > 0) {
    char letra = Serial.read();

    if (letra == '\n' || letra == '\r') {
      if (tamanhoDoBuffer > 0) {
        bufferDaSerial[tamanhoDoBuffer] = '\0';
        executarComando(bufferDaSerial);
        tamanhoDoBuffer = 0;
      }
    } else if (tamanhoDoBuffer < (int)sizeof(bufferDaSerial) - 1) {
      bufferDaSerial[tamanhoDoBuffer] = letra;
      tamanhoDoBuffer++;
    }
  }
}

// Todos os ajustes, na ordem em que "valores" mostra. O pid-robot espera "kp"
// primeiro e "telemetria" por último.
const char *const NOMES_DOS_AJUSTES[] = {
  "kp", "ki", "kd", "angulo_equilibrio", "angulo_queda", "usar_laco_velocidade", "kv",
  "pwm_minimo", "usar_filtro_d", "filtro_termo_d", "usar_curva", "curva_motor", "usar_rampa", "rampa_motor",
  "peso_giroscopio", "divisor_amostragem", "filtro_passa_baixas", "escala_acelerometro",
  "telemetria",
};
const int QUANTIDADE_DE_AJUSTES = sizeof(NOMES_DOS_AJUSTES) / sizeof(NOMES_DOS_AJUSTES[0]);

// Recebe uma linha como "kp 25" ou "marcar_equilibrio" e faz o que ela pede.
void executarComando(char *linha) {
  // Separa a linha no primeiro espaço: "kp 25" vira nome "kp" e valor "25".
  char *nome = linha;
  char *valorEmTexto = strchr(linha, ' ');
  bool veioComValor = false;
  float valor = 0.0;

  if (valorEmTexto != NULL) {
    *valorEmTexto = '\0';          // o nome termina onde estava o espaço
    valorEmTexto++;                // e o valor começa logo depois
    veioComValor = (strpbrk(valorEmTexto, "0123456789") != NULL);
    valor = atof(valorEmTexto);
  }
  strlwr(nome);                    // "KP" vira "kp", para responder com o nome certo

  // Comandos que não levam número.
  if (nomeDoComandoE(nome, "ajuda")) {
    mostrarAjuda();
    return;
  }
  if (nomeDoComandoE(nome, "valores")) {
    mostrarAjustes();
    return;
  }
  if (nomeDoComandoE(nome, "marcar_equilibrio")) {
    anguloDeEquilibrio = anguloAtual;
    confirmarAjuste("angulo_equilibrio");
    return;
  }
  if (nomeDoComandoE(nome, "telemetria")) {
    telemetriaLigada = !telemetriaLigada;
    confirmarAjuste("telemetria");
    return;
  }

  // Os outros mudam um valor e precisam do número. Sem ele, avisamos em vez de
  // zerar o valor sem querer.
  if (!ajusteExiste(nome)) {
    Serial.print(F("# Comando desconhecido: \""));
    Serial.print(nome);
    Serial.println(F("\""));
    mostrarAjuda();
    return;
  }
  if (!veioComValor) {
    Serial.print(F("# Faltou o numero depois de \""));
    Serial.print(nome);
    Serial.println(F("\". Exemplo: kp 20"));
    return;
  }
  if (aplicarAjuste(nome, valor)) {
    confirmarAjuste(nome);
  }
}

// Muda um ajuste, respeitando os limites. Devolve false se não deu certo
// (o MPU6050 recusou a mudança, por exemplo).
bool aplicarAjuste(const char *nome, float valor) {
  if (nomeDoComandoE(nome, "kp")) {
    Kp = valor;
  } else if (nomeDoComandoE(nome, "ki")) {
    Ki = valor;
  } else if (nomeDoComandoE(nome, "kd")) {
    Kd = valor;
  } else if (nomeDoComandoE(nome, "angulo_equilibrio")) {
    anguloDeEquilibrio = valor;
  } else if (nomeDoComandoE(nome, "angulo_queda")) {
    anguloDeQueda = constrain(valor, ANGULO_DE_QUEDA_MINIMO, ANGULO_DE_QUEDA_MAXIMO);
  } else if (nomeDoComandoE(nome, "usar_laco_velocidade")) {
    usarLacoDeVelocidade = (valor != 0);
  } else if (nomeDoComandoE(nome, "kv")) {
    Kv = constrain(valor, 0.0, KV_MAXIMO);
  } else if (nomeDoComandoE(nome, "pwm_minimo")) {
    pwmMinimo = constrain((int)valor, 0, PWM_MAXIMO - 1);
  } else if (nomeDoComandoE(nome, "usar_filtro_d")) {
    usarFiltroNoTermoD = (valor != 0);
  } else if (nomeDoComandoE(nome, "filtro_termo_d")) {
    frequenciaDoFiltroDoTermoD = constrain(valor, FREQUENCIA_DO_FILTRO_DO_TERMO_D_MINIMA,
                                           FREQUENCIA_DO_FILTRO_DO_TERMO_D_MAXIMA);
  } else if (nomeDoComandoE(nome, "usar_curva")) {
    usarCurva = (valor != 0);
  } else if (nomeDoComandoE(nome, "curva_motor")) {
    curvaDoMotor = constrain(valor, 0.0, 1.0);
  } else if (nomeDoComandoE(nome, "usar_rampa")) {
    usarRampa = (valor != 0);
  } else if (nomeDoComandoE(nome, "rampa_motor")) {
    rampaDoMotor = constrain(valor, RAMPA_DO_MOTOR_MINIMA, RAMPA_DO_MOTOR_MAXIMA);
  } else if (nomeDoComandoE(nome, "peso_giroscopio")) {
    pesoDoGiroscopio = constrain(valor, 0.0, 1.0);
  } else if (nomeDoComandoE(nome, "divisor_amostragem")) {
    // Vai direto para o sensor. Só guarda o valor novo se ele aceitar: assim o
    // que aparece em "valores" é sempre o que está gravado no MPU6050.
    uint8_t novoDivisor = constrain((int)valor, DIVISOR_DE_AMOSTRAGEM_MINIMO, DIVISOR_DE_AMOSTRAGEM_MAXIMO);
    if (!escreverRegistrador(REG_DIVISOR_DE_AMOSTRAGEM, novoDivisor)) {
      Serial.println(F("# ERRO: o MPU6050 nao aceitou o divisor de amostragem."));
      return false;
    }
    divisorDeAmostragem = novoDivisor;
  } else if (nomeDoComandoE(nome, "filtro_passa_baixas")) {
    uint8_t novoFiltro = constrain((int)valor, FILTRO_PASSA_BAIXAS_MINIMO, FILTRO_PASSA_BAIXAS_MAXIMO);
    if (!escreverRegistrador(REG_FILTRO_PASSA_BAIXAS, novoFiltro)) {
      Serial.println(F("# ERRO: o MPU6050 nao aceitou o filtro passa-baixas."));
      return false;
    }
    filtroPassaBaixas = novoFiltro;
  } else if (nomeDoComandoE(nome, "escala_acelerometro")) {
    uint8_t novaEscala = escalaDoAcelerometroMaisProxima(valor);
    if (!escreverRegistrador(REG_ESCALA_ACELEROMETRO, valorDoRegistradorDeEscala(novaEscala))) {
      Serial.println(F("# ERRO: o MPU6050 nao aceitou a escala do acelerometro."));
      return false;
    }
    escalaDoAcelerometroEmG = novaEscala;
  }
  return true;
}

// Escreve "nome=valor" de um ajuste, com as mesmas casas decimais que o
// pid-robot espera.
void mostrarAjuste(const char *nome) {
  Serial.print(nome);
  Serial.print('=');
  if      (nomeDoComandoE(nome, "kp"))                   Serial.print(Kp, 2);
  else if (nomeDoComandoE(nome, "ki"))                   Serial.print(Ki, 2);
  else if (nomeDoComandoE(nome, "kd"))                   Serial.print(Kd, 3);
  else if (nomeDoComandoE(nome, "angulo_equilibrio"))    Serial.print(anguloDeEquilibrio, 2);
  else if (nomeDoComandoE(nome, "angulo_queda"))         Serial.print(anguloDeQueda, 1);
  else if (nomeDoComandoE(nome, "usar_laco_velocidade")) Serial.print(usarLacoDeVelocidade ? 1 : 0);
  else if (nomeDoComandoE(nome, "kv"))                   Serial.print(Kv, 3);
  else if (nomeDoComandoE(nome, "pwm_minimo"))           Serial.print(pwmMinimo);
  else if (nomeDoComandoE(nome, "usar_filtro_d"))        Serial.print(usarFiltroNoTermoD ? 1 : 0);
  else if (nomeDoComandoE(nome, "filtro_termo_d"))       Serial.print(frequenciaDoFiltroDoTermoD, 1);
  else if (nomeDoComandoE(nome, "usar_curva"))           Serial.print(usarCurva ? 1 : 0);
  else if (nomeDoComandoE(nome, "curva_motor"))          Serial.print(curvaDoMotor, 2);
  else if (nomeDoComandoE(nome, "usar_rampa"))           Serial.print(usarRampa ? 1 : 0);
  else if (nomeDoComandoE(nome, "rampa_motor"))          Serial.print(rampaDoMotor, 0);
  else if (nomeDoComandoE(nome, "peso_giroscopio"))      Serial.print(pesoDoGiroscopio, 3);
  else if (nomeDoComandoE(nome, "divisor_amostragem"))   Serial.print(divisorDeAmostragem);
  else if (nomeDoComandoE(nome, "filtro_passa_baixas"))  Serial.print(filtroPassaBaixas);
  else if (nomeDoComandoE(nome, "escala_acelerometro"))  Serial.print(escalaDoAcelerometroEmG);
  else if (nomeDoComandoE(nome, "telemetria"))           Serial.print(telemetriaLigada ? F("ligada") : F("desligada"));
}

bool ajusteExiste(const char *nome) {
  for (int i = 0; i < QUANTIDADE_DE_AJUSTES; i++) {
    if (nomeDoComandoE(nome, NOMES_DOS_AJUSTES[i])) {
      return true;
    }
  }
  return false;
}

// Resposta curta a um comando: "# ok kp=22.00".
void confirmarAjuste(const char *nome) {
  Serial.print(F("# ok "));
  mostrarAjuste(nome);
  Serial.println();
}

// Compara o nome digitado com o esperado, sem ligar para maiúsculas.
bool nomeDoComandoE(const char *nomeDigitado, const char *nomeEsperado) {
  return strcasecmp(nomeDigitado, nomeEsperado) == 0;
}

void mostrarAjuda() {
  Serial.println(F("# Comandos:"));
  Serial.println(F("#   kp 20                   ganho proporcional"));
  Serial.println(F("#   ki 40                   ganho integral"));
  Serial.println(F("#   kd 0.8                  ganho derivativo"));
  Serial.println(F("#   angulo_equilibrio -1.5  angulo em que o robo fica em pe"));
  Serial.println(F("#   marcar_equilibrio       usa o angulo atual como equilibrio"));
  Serial.println(F("#   angulo_queda 35         inclinacao a partir da qual o robo caiu (5 a 80)"));
  Serial.println(F("#   usar_laco_velocidade 1  liga (1) ou desliga (0) o laco de velocidade"));
  Serial.println(F("#   kv 0.02                 graus de alvo por unidade de comando (0 a 0.5)"));
  Serial.println(F("#   pwm_minimo 40           menor PWM que faz o motor girar"));
  Serial.println(F("#   usar_filtro_d 1         liga (1) ou desliga (0) o filtro no termo D"));
  Serial.println(F("#   filtro_termo_d 25       corte do filtro no termo D, em Hz (1 a 150)"));
  Serial.println(F("#   usar_curva 1            liga (1) ou desliga (0) a curva do motor"));
  Serial.println(F("#   curva_motor 0.5         0 = reta, 1 = cubica (0 a 1)"));
  Serial.println(F("#   usar_rampa 1            liga (1) ou desliga (0) a rampa do motor"));
  Serial.println(F("#   rampa_motor 1500        variacao maxima do comando por segundo (50 a 20000)"));
  Serial.println(F("#   peso_giroscopio 0.98    quanto o filtro confia no giroscopio (0 a 1)"));
  Serial.println(F("#   divisor_amostragem 4    medicoes por segundo = 1000 / (1 + divisor) (1 a 19)"));
  Serial.println(F("#   filtro_passa_baixas 3   filtro do MPU6050: 1 = 188 Hz ... 6 = 5 Hz (1 a 6)"));
  Serial.println(F("#   escala_acelerometro 2   faixa do acelerometro em g: 2, 4, 8 ou 16"));
  Serial.println(F("#   telemetria              liga/desliga o envio de numeros"));
  Serial.println(F("#   valores                 mostra os valores atuais"));
  Serial.println(F("#   ajuda                   mostra esta lista"));
}

// O programa ferramentas/pid-robot lê esta linha, a "# ok" e a da telemetria:
// se mudar o formato de alguma delas, ajuste o programa também.
void mostrarAjustes() {
  Serial.print(F("# "));
  for (int i = 0; i < QUANTIDADE_DE_AJUSTES; i++) {
    if (i > 0) {
      Serial.print(F("  "));
    }
    mostrarAjuste(NOMES_DOS_AJUSTES[i]);
  }
  Serial.println();
}

// Formato "nome:valor,nome:valor" — abre direto no Plotter Serial da IDE.
void enviarTelemetria() {
  if (!telemetriaLigada) return;
  if (millis() - instanteDaUltimaTelemetria < INTERVALO_DA_TELEMETRIA_MS) return;
  instanteDaUltimaTelemetria = millis();

  Serial.print(F("angulo:"));              Serial.print(anguloAtual, 2);
  Serial.print(F(",angulo_equilibrio:"));  Serial.print(anguloDeEquilibrio, 2);
  Serial.print(F(",termo_P:"));            Serial.print(ultimoTermoP, 1);
  Serial.print(F(",termo_I:"));            Serial.print(termoIntegral, 1);
  Serial.print(F(",termo_D:"));            Serial.print(ultimoTermoD, 1);
  Serial.print(F(",termo_V:"));            Serial.print(ultimoTermoV, 2);
  Serial.print(F(",comando_pid:"));        Serial.print(ultimoComandoDoPid, 0);
  Serial.print(F(",comando_motor:"));      Serial.println(ultimoComando, 0);
}
